lucafaccin/HT_485/HT485_DS/HT485_DS.step

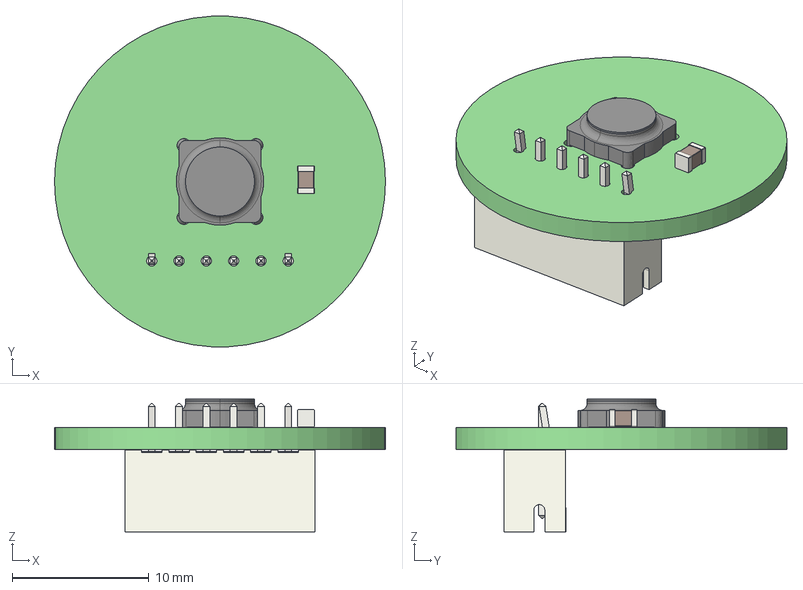
[picture p1: CAD file, 2022-10-22]
HT485_DS/HT485_DS.step
24.2 x 24.2 x 9.73 mm
HT485_DS PCB
