lucafaccin/HT_485/HT_485.kicad_pcb

## KiCad design HT_485.kicad_pcb (2024-10-04)

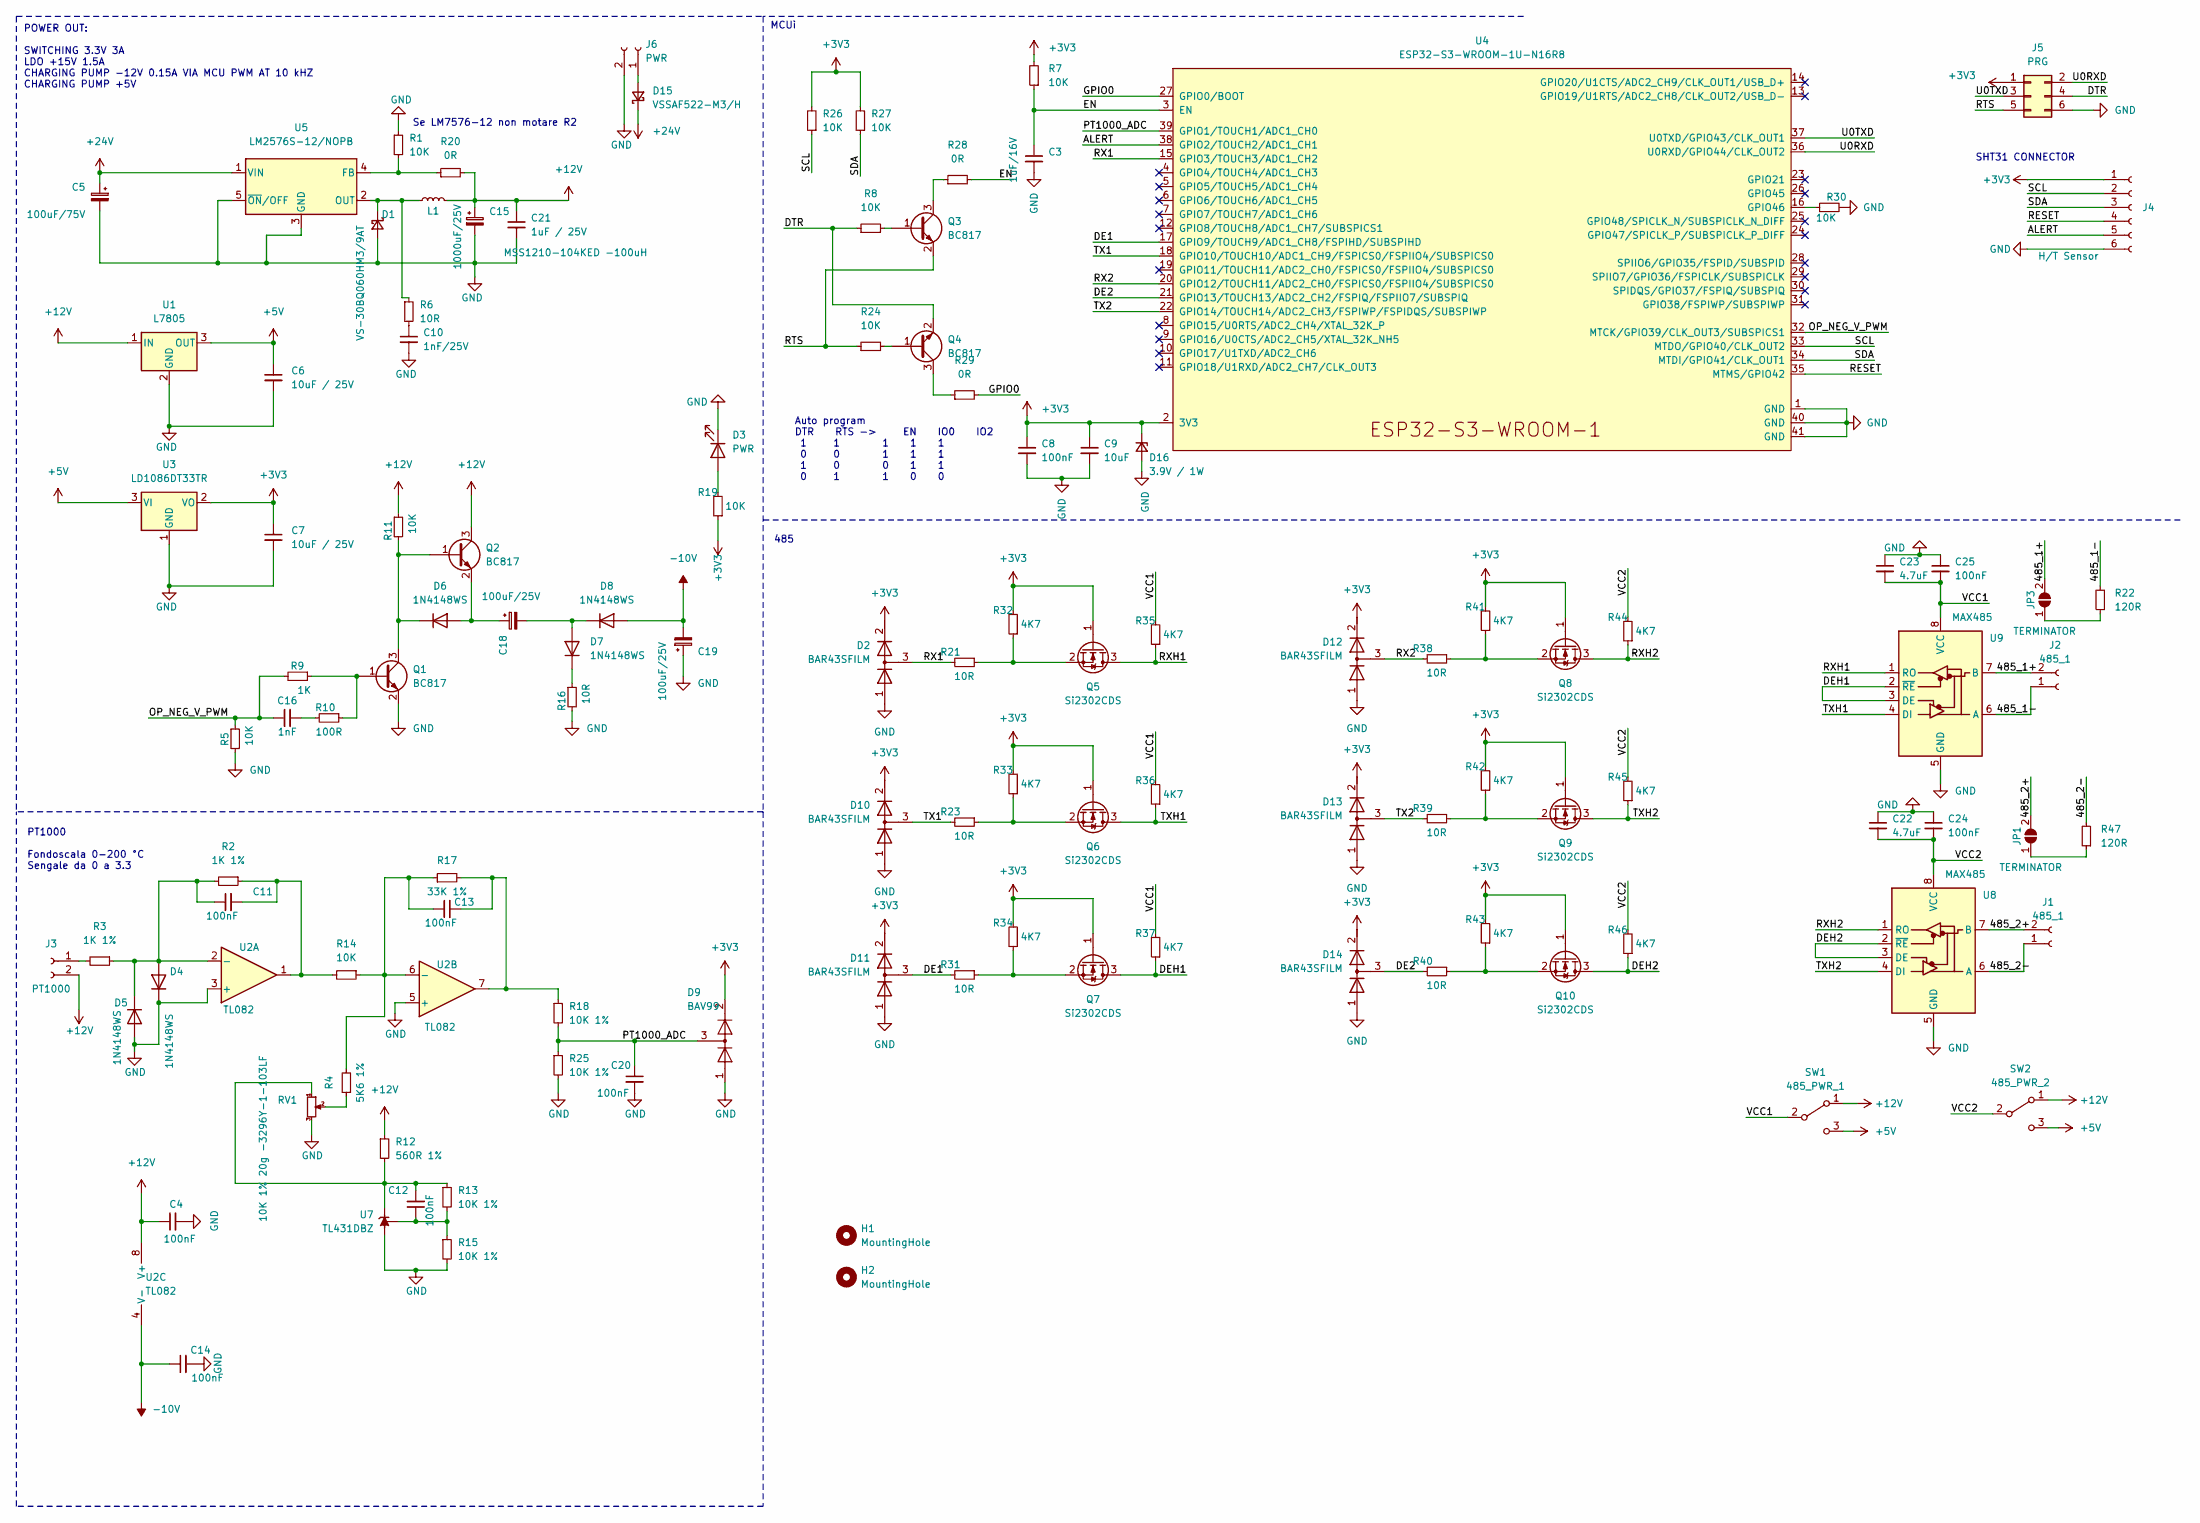
[picture p2: schematic HT_485.kicad_sch, HT 485]

Parts:
C3: 1uF/16V; C_0805_2012Metric
C4, C8, C11, C12, C13, C14, C20, C24, C25: 100nF; C_0805_2012Metric
C5: 100uF/75V; CP_Elec_8x10.5
C6, C7: 10uF / 25V; C_0805_2012Metric
C9: 10uF; C_0805_2012Metric
C10: 1nF/25V; C_0805_2012Metric
C15: 1000uF/25V; CP_Elec_10x10.5
C16: 1nF; C_0805_2012Metric
C18, C19: 100uF/25V; CP_Elec_6.3x7.7
C21: 1uF / 25V; C_0805_2012Metric
C22, C23: 4.7uF; C_0805_2012Metric
D1: VS-30BQ060HM3/9AT; D_SMB-SMC_Universal_Handsoldering
D2, D10, D11, D12, D13, D14: BAR43SFILM; SOT-23
D3: PWR; LED_0805_2012Metric
D4, D5, D6, D7, D8: 1N4148WS; D_SOD-323
D9: BAV99; SOT-23
D15: VSSAF522-M3/H; D_SMA-SMB_Universal_Handsoldering
D16: 3.9V / 1W; D_SOD-128
H1, H2: MountingHole; MountingHole_3.2mm_M3
J1, J2: 485_1; TerminalBlock_Phoenix_PT-1,5-2-5.0-H_1x02_P5.00mm_Horizontal
J3: PT1000; TerminalBlock_Phoenix_PT-1,5-2-3.5-H_1x02_P3.50mm_Horizontal
J4: H/T Sensor; JST_PH_S6B-PH-SM4-TB_1x06-1MP_P2.00mm_Horizontal
J5: PRG; PinSocket_2x03_P2.54mm_Vertical
J6: PWR; TerminalBlock_Phoenix_PT-1,5-2-5.0-H_1x02_P5.00mm_Horizontal
JP1, JP3: TERMINATOR; SolderJumper-2_P1.3mm_Open_RoundedPad1.0x1.5mm
L1: MSS1210-104KED -100uH; MSS1210-104KED
Q1, Q2, Q3, Q4: BC817; SOT-23
Q5, Q6, Q7, Q8, Q9, Q10: Si2302CDS; SOT-23
R1, R5, R7, R8, R11, R14, R19, R24, R26, R27, R30: 10K; R_0805_2012Metric_Pad1.20x1.40mm_HandSolder
R2, R3: 1K 1%; R_0805_2012Metric_Pad1.20x1.40mm_HandSolder
R4: 5K6 1%; R_0805_2012Metric_Pad1.20x1.40mm_HandSolder
R6, R16, R21, R23, R31, R38, R39, R40: 10R; R_0805_2012Metric_Pad1.20x1.40mm_HandSolder
R9: 1K; R_0805_2012Metric_Pad1.20x1.40mm_HandSolder
R10: 100R; R_0805_2012Metric_Pad1.20x1.40mm_HandSolder
R12: 560R 1%; R_0805_2012Metric_Pad1.20x1.40mm_HandSolder
R13, R15, R18, R25: 10K 1%; R_0805_2012Metric_Pad1.20x1.40mm_HandSolder
R17: 33K 1%; R_0805_2012Metric_Pad1.20x1.40mm_HandSolder
R20, R28, R29: 0R; R_0805_2012Metric_Pad1.20x1.40mm_HandSolder
R22, R47: 120R; R_0805_2012Metric_Pad1.20x1.40mm_HandSolder
R32, R33, R34, R35, R36, R37, R41, R42, R43, R44, R45, R46: 4K7; R_0805_2012Metric_Pad1.20x1.40mm_HandSolder
RV1: 10K 1% 20g -3296Y-1-103LF; Potentiometer_Bourns_3296Y_Vertical
SW1: 485_PWR_1; PinHeader_1x03_P2.54mm_Vertical
SW2: 485_PWR_2; PinHeader_1x03_P2.54mm_Vertical
U1: L7805; TO-252-3_TabPin2
U2: TL082; SOIC-8-1EP_3.9x4.9mm_P1.27mm_EP2.29x3mm
U3: LD1086DT33TR; TO-252-3_TabPin2
U4: ESP32-S3-WROOM-1U-N16R8; ESP32-S3-WROOM-1
U5: LM2576S-12/NOPB; TO-263-5_TabPin3
U7: TL431DBZ; SOT-23
U8, U9: MAX485; SOIC-8_3.9x4.9mm_P1.27mm

Connections:
+3V3: C7.1, C8.1, C9.1, D2.2 (K), D9.2 (A), D10.2 (K), D11.2 (K), D12.2 (K), D13.2 (K), D14.2 (K), D16.1 (K), J4.1, J5.1, Q5.1 (G), Q6.1 (G), Q7.1 (G), Q8.1 (G), Q9.1 (G), Q10.1 (G), R7.2, R19.1, R26.2, R27.2, R32.2, R33.2, R34.2, R41.2, R42.2, R43.2, U3.2 (VO), U4.2 (3V3)
+5V: C6.1, SW1.3 (C), SW2.3 (C), U1.3 (OUT), U3.3 (VI)
+12V: C4.1, C15.1, C21.1, J3.2, L1.2, Q2.3 (C), R11.1, R12.1, R20.2, SW1.1 (A), SW2.1 (A), U1.1 (IN), U2.8 (V+)
+24V: C5.1, D15.1 (K), U5.1 (VIN)
-10V: C14.1, C19.2, D8.2 (A), U2.4 (V-)
/485_1+: J2.2, JP3.2 (B), U9.7 (B)
/485_1-: J2.1, R22.2, U9.6 (A)
/485_2+: J1.2, JP1.2 (B), U8.7 (B)
/485_2-: J1.1, R47.2, U8.6 (A)
/ALERT: J4.5, U4.38 (GPIO2/TOUCH2/ADC1_CH1)
/DE1: D11.3 (common), R31.2, U4.17 (GPIO9/TOUCH9/ADC1_CH8/FSPIHD/SUBSPIHD)
/DE2: D14.3 (common), R40.2, U4.21 (GPIO13/TOUCH13/ADC2_CH2/FSPIQ/FSPIIO7/S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)
/DEH1: Q7.3 (D), R37.1, U9.2 (~RE), U9.3 (DE)
/DEH2: Q10.3 (D), R46.1, U8.2 (~RE), U8.3 (DE)
/DTR: J5.4, Q4.2 (E), R8.1
/EN: C3.1, R7.1, R28.2, U4.3 (EN)
/GPIO0: R29.2, U4.27 (GPIO0/BOOT)
/OP_NEG_V_PWM: C16.1, R5.1, R9.2, U4.32 (MTCK/GPIO39/CLK_OUT3/SUBSPICS1)
/PT1000_ADC: C20.1, D9.3 (K), R18.2, R25.1, U4.39 (GPIO1/TOUCH1/ADC1_CH0)
/RESET: J4.4, U4.35 (MTMS/GPIO42)
/RTS: J5.5, Q3.2 (E), R24.1
/RX1: D2.3 (common), R21.2, U4.15 (GPIO3/TOUCH3/ADC1_CH2)
/RX2: D12.3 (common), R38.2, U4.20 (GPIO12/TOUCH11/ADC2_CH0/FSPICS0/FSPIIO4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)
/RXH1: Q5.3 (D), R35.1, U9.1 (RO)
/RXH2: Q8.3 (D), R44.1, U8.1 (RO)
/SCL: J4.2, R26.1, U4.33 (MTDO/GPIO40/CLK_OUT2)
/SDA: J4.3, R27.1, U4.34 (MTDI/GPIO41/CLK_OUT1)
/TX1: D10.3 (common), R23.2, U4.18 (GPIO10/TOUCH10/ADC1_CH9/FSPICS0/FSPIIO4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)
/TX2: D13.3 (common), R39.2, U4.22 (GPIO14/TOUCH14/ADC2_CH3/FSPIWP/FSPIDQS/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)
/TXH1: Q6.3 (D), R36.1, U9.4 (DI)
/TXH2: Q9.3 (D), R45.1, U8.4 (DI)
/U0RXD: J5.2, U4.36 (U0RXD/GPIO44/CLK_OUT2)
/U0TXD: J5.3, U4.37 (U0TXD/GPIO43/CLK_OUT1)
/VCC1: C23.2, C25.2, R35.2, R36.2, R37.2, SW1.2 (B), U9.8 (VCC)
/VCC2: C22.2, C24.2, R44.2, R45.2, R46.2, SW2.2 (B), U8.8 (VCC)
GND: C3.2, C4.2, C5.2, C6.2, C7.2, C8.2, C9.2, C10.2, C14.2, C15.2, C19.1, C20.2, C21.2, C22.1, C23.1, C24.1, C25.1, D1.2 (A), D2.1 (A), D3.1 (K), D4.1 (K), D5.2 (A), D9.1 (K), D10.1 (A), D11.1 (A), D12.1 (A), D13.1 (A), D14.1 (A), D16.2 (A), J4.6, J5.6, J6.2, Q1.2 (E), R1.1, R5.2, R15.2, R16.2, R25.2, R30.2, RV1.3, U1.2 (GND), U2.3 (+), U2.5 (+), U3.1 (GND), U4.1 (GND), U4.40 (GND), U4.41 (GND), U5.3 (GND), U5.5 (~ON/OFF), U7.3 (A), U8.5 (GND), U9.5 (GND)
unnamed: C10.1, R6.2
unnamed: C11.2, R2.1, R14.2, U2.1
unnamed: C13.2, R17.2, R18.1, U2.7
unnamed: C16.2, R10.2
unnamed: D1.1 (K), L1.1, R6.1, U5.2 (OUT)
unnamed: D3.2 (A), R19.2
unnamed: C11.1, D4.2 (A), D5.1 (K), R2.2, R3.1, U2.2 (-)
unnamed: C18.1, D6.2 (A), Q2.2 (E)
unnamed: D6.1 (K), Q1.3 (C), Q2.1 (B), R11.2
unnamed: C18.2, D7.2 (A), D8.1 (K)
unnamed: D7.1 (K), R16.1
unnamed: D15.2 (A), J6.1
unnamed: J3.1, R3.2
unnamed: JP1.1 (A), R47.1
unnamed: JP3.1 (A), R22.1
unnamed: Q1.1 (B), R9.1, R10.1
unnamed: Q3.1 (B), R8.2
unnamed: Q3.3 (C), R28.1
unnamed: Q4.1 (B), R24.2
unnamed: Q4.3 (C), R29.1
unnamed: Q5.2 (S), R21.1, R32.1
unnamed: Q6.2 (S), R23.1, R33.1
unnamed: Q7.2 (S), R31.1, R34.1
unnamed: Q8.2 (S), R38.1, R41.1
unnamed: Q9.2 (S), R39.1, R42.1
unnamed: Q10.2 (S), R40.1, R43.1
unnamed: R4.1, RV1.2
unnamed: C13.1, R4.2, R14.1, R17.1, U2.6 (-)
unnamed: R30.1, U4.16 (GPIO46)
unnamed: R1.2, R20.1, U5.4 (FB)
unnamed: C12.2, R12.2, R13.1, RV1.1, U7.1 (K)
unnamed: C12.1, R13.2, R15.1, U7.2 (REF)

Notes on the sheet:
Auto program DTR RTS -> EN IO0 IO2 1 1 1 1 1 0 0 1 1 1 1 0 0 1 1 0 1 1 0 0
485
Se LM7576-12 non motare R2
SHT31 CONNECTOR
MCUì
PT1000 Fondoscala 0-200 °C Sengale da 0 a 3.3
POWER OUT: SWITCHING 3.3V 3A LDO +15V 1.5A CHARGING PUMP -12V 0.15A VIA MCU PWM AT 10 kHZ CHARGING PUMP +5V

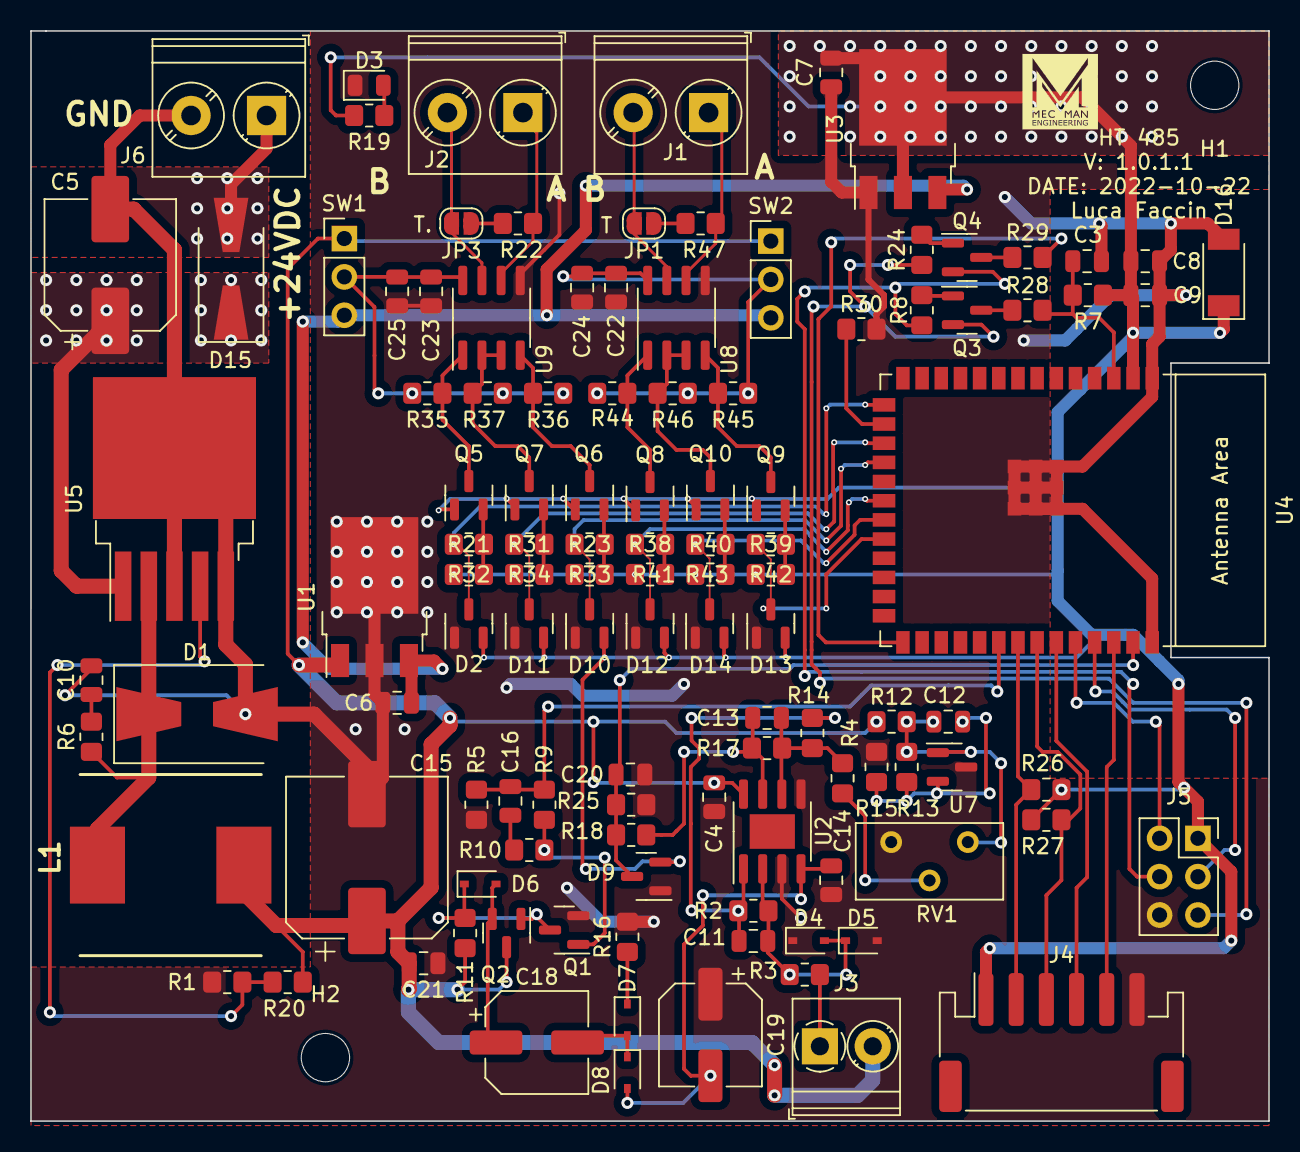
[picture p3: board HT_485.kicad_pcb from above]

Board: 2 copper layers, 82.0 x 72.2 mm, 117 parts (0 on the bottom side), 68 nets.
