lucafaccin/HT_485/HT485_DS/HT485_DS.kicad_pcb

## KiCad design HT485_DS/HT485_DS.kicad_pcb (2022-10-14)

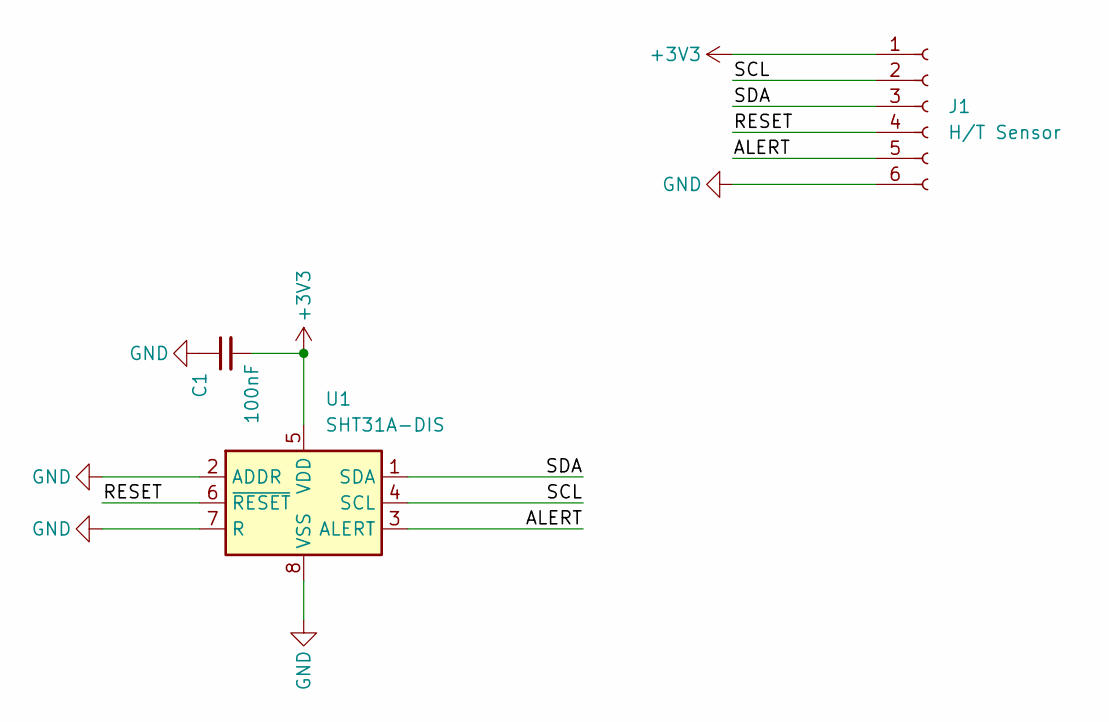
[picture p4: schematic HT485_DS.kicad_sch, Digital Umidity Temperature Sensor over 485]

Parts:
C1: 100nF; C_0805_2012Metric
J1: H/T Sensor; JST_PH_B6B-PH-K_1x06_P2.00mm_Vertical
U1: SHT31A-DIS; Sensirion_DFN-8-1EP_2.5x2.5mm_P0.5mm_EP1.1x1.7mm

Connections:
+3V3: C1.2, J1.1, U1.5 (VDD)
/ALERT: J1.5, U1.3 (ALERT)
/RESET: J1.4, U1.6 (~RESET)
/SCL: J1.2, U1.4 (SCL)
/SDA: J1.3, U1.1 (SDA)
GND: C1.1, J1.6, U1.2 (ADDR), U1.7 (R), U1.8 (VSS), U1.9 (VSS)

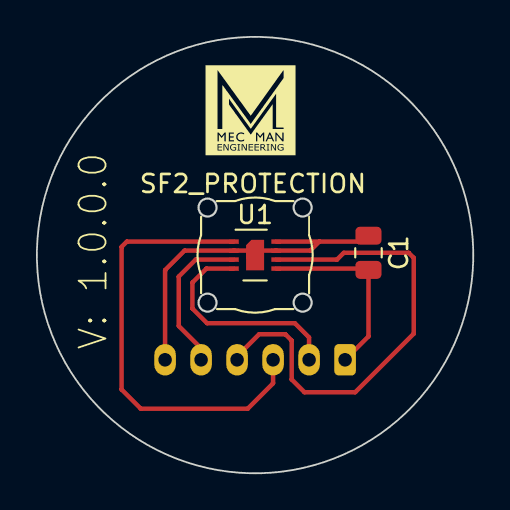
[picture p5: board HT485_DS.kicad_pcb from above]

Board: 2 copper layers, 24.2 x 24.2 mm, 4 parts (1 on the bottom side), 6 nets.

Other parts of the board:
SF2_PROTECTION: SF2
