lucafaccin/HT_485/(commit log)

2022-07-07 Lavoro terminato
    [HT_485.kicad_pcb, HT_485.kicad_sch]
2022-07-08 Adattato master a scatola
    [HT_485.kicad_pcb, HT_485.kicad_sch]
2022-07-08 Modificata posizione resistenze
    [HT_485.kicad_pcb]
2022-07-11 Aggiunto terminatore 485
    [HT_485.kicad_pcb, HT_485.kicad_sch]
2022-07-12 Aggiunti 3D Sensori
2022-07-12 Rivisti dip switch con solder jumper
    [HT_485.kicad_pcb, HT_485.kicad_sch]
2022-07-13 Messa pompa di carica per 485 a 5V
    [HT_485.kicad_pcb, HT_485.kicad_sch]
2022-09-09 Revisione 1.0.0.0 con PT1000
    [HT_485.kicad_pcb, HT_485.kicad_sch]
2022-09-12 Cambiata traccia per 3v3 e alimentatore switching
    [HT_485.kicad_pcb]
2022-10-08 Sistemate resistenze di centratura PT1000
    [HT_485.kicad_sch]
2022-10-08 Aggiunto progetto Sensore i2C
    [HT485_DS.kicad_pcb, HT485_DS.kicad_sch, HT_485.kicad_sch]
2022-10-08 Fatta scheda sensore
    [HT485_DS.kicad_pcb, HT485_DS.kicad_sch]
2022-10-08 Aggiornato gerber
    [HT485_DS.kicad_pcb]
2022-10-10 Provato cambio resistenze operazionali. NULLA
    [HT_485.kicad_sch]
2022-10-11 Ancora problemi PT1000
    [HT_485.kicad_sch]
2022-10-14 Rimosso piano di massa da sensore T/H digitale Aggiunti dati per produzione JLCPCB
    [HT485_DS.kicad_pcb, bom.csv, designators.csv, positions.csv]
2022-10-16 Rivisto completamente PT1000 ingresso
    [HT_485.kicad_sch]
2022-10-17 Rifatto schema 485. Master da rifare
    [HT_485.kicad_pcb, HT_485.kicad_sch]
2022-10-17 Rivisto tutta la scheda
    [HT_485.kicad_pcb, HT_485.kicad_sch]
2022-10-17 Aggiunto diodo per alimentazione CPU
    [HT_485.kicad_pcb, HT_485.kicad_sch]
2022-10-17 Correto mosfet voltage shifter.
    [HT_485.kicad_sch]
2022-10-22 Revisionato master
    [HT485_DS.step, HT_485.kicad_pcb, HT_485.kicad_sch]
2022-10-22 Aggiunti logo MME. Versione 1.0.1.0
    [HT_485.kicad_pcb, HT_485.kicad_sch, bom.csv, designators.csv, positions.csv]
2024-10-04 Messi connettori 485 a passo 5. Aggiornata versione a 1.0.1.1
    [HT_485.kicad_pcb, HT_485.kicad_sch, bom.csv, designators.csv, positions.csv]
